zach-bowman/EDL/poster.pdf

# FORGETME NOT: Memory Aid Using RFID Object Detection and WiFi Communication

## Zach Bowman, Anne Pigula

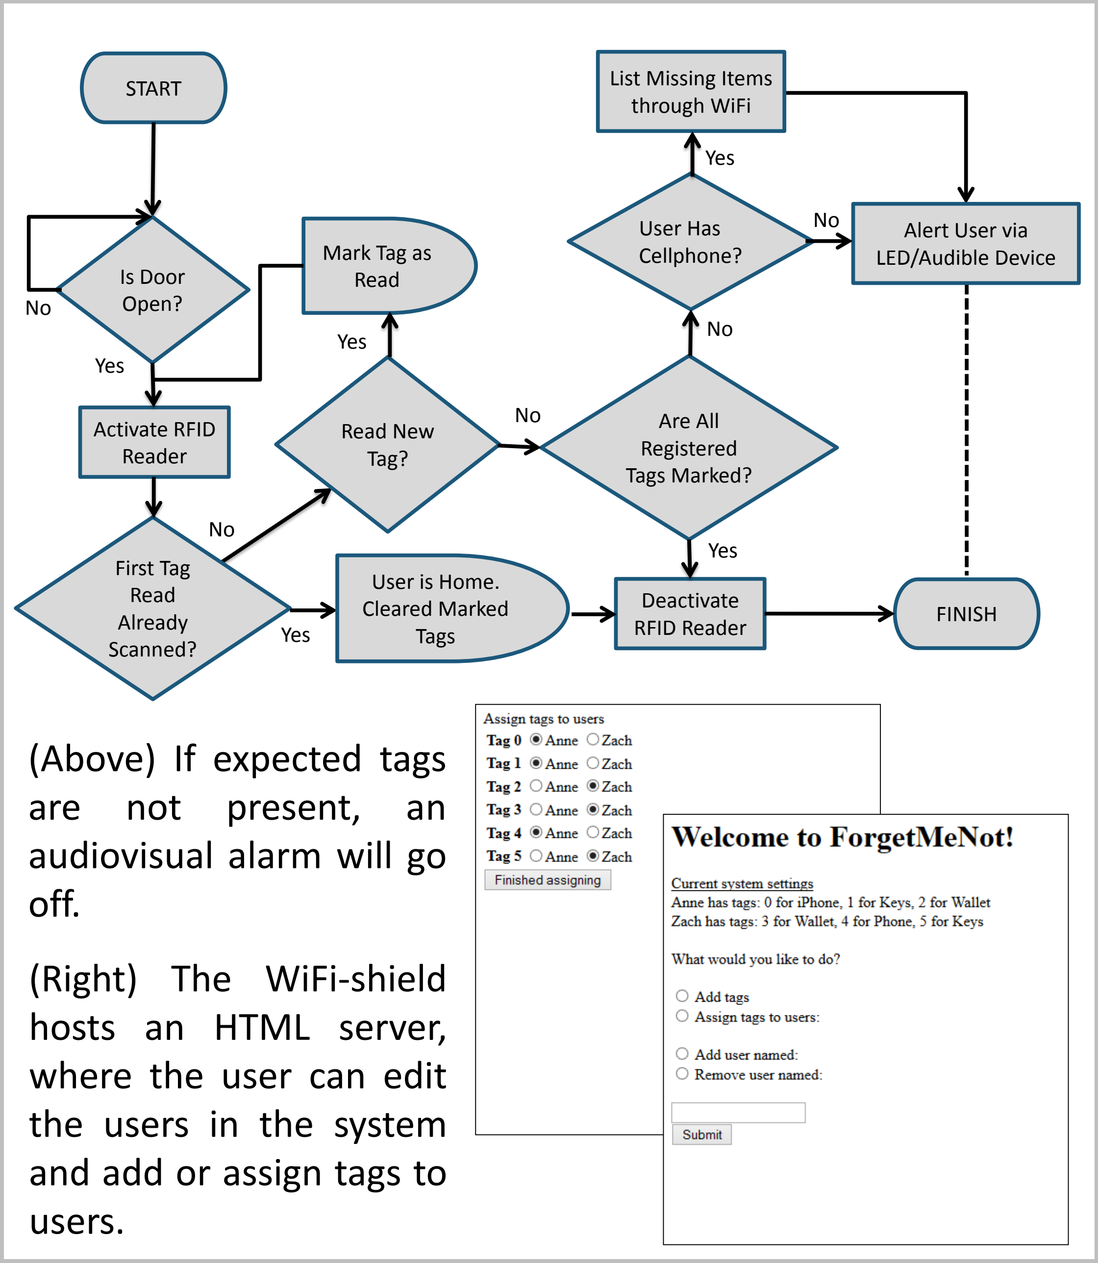
[picture p7: figure]
(Right) The WiFi-shield hosts an HTML server, where the user can edit the users in the system and add or assign tags to users.; Yes; START; Activate RFID Reader; Read New Tag?; Mark Tag as Read; Are All Registered Tags Marked?; Deactivate RFID Reader; FINISH; User Has Cellphone?; Alert User via LED/Audible Device; List Missing Items through WiFi; Is Door Open?; First Tag Read Already Scanned?; User is Home. Cleared Marked Tags; (Above) If expected tags are not present, an audiovisual alarm will go off.

Conclusions and Future Work

Device Overview

## Department of Electrical and Computer Engineering

Acknowledgements and Reference

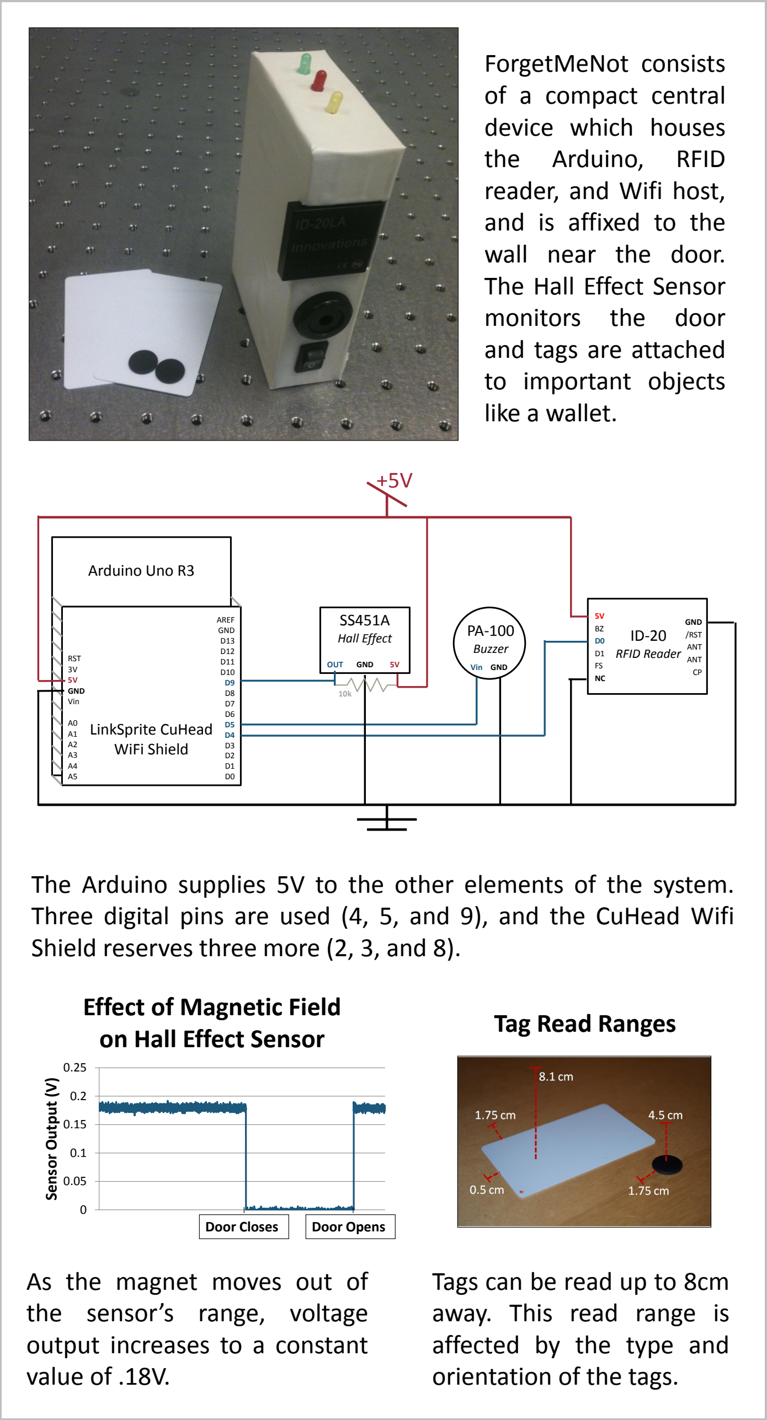
[picture p8: figure]
Tags can be read up to 8cm away. This read range is affected by the type and orientation of the tags.; As the magnet moves out of the sensor’s range, voltage output increases to a constant value of .18V.; Sensor Output (V); Effect of Magnetic Field on Hall Effect Sensor; Door Closes; Door Opens; Arduino Uno R3; LinkSprite CuHead WiFi Shield; RST 3V 5V GND Vin; AREF GND D13; ID-20 RFID Reader; GND /RST ANT ANT CP; PA-100 Buzzer; Vin GND; SS451A Hall Effect; OUT; GND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

EN.520.448 Electronics Design Lab | Spring 2013

User Feedback

ForgetMeNot is an effective model for an RFID-based memory aid system.
An ideal system would include the following upgrades:
- High-frequency RFID (~900MHz) to allow simultaneous tracking of multiple tags at a range of 1-2m
- A more powerful processor with additional memory
- A smartphone app with PUSH notifications

Introduction

Technology / Components

ID-20 RFID reader and tags: A low-frequency system with an advertised range of 20cm. Although a high-frequency system would have better range and minimal interference, the ID-20 meets our budgetary restrictions and is sufficient for a proof-of-technology model.

Arduino | Uno | R3: | A | single-board
microcontroller to manage the sensors and instruments, with 32kb of memory, as well as open-source software.

CuHead Wifi Shield for Arduino: Provides wireless connectivity to the Arduino, allowing the system to host a server on the local internet.

SS451A Hall Effect sensor and magnet: A simple proximity sensor which indicates when the door is opened

A PA-100 piezoelectric buzzer and LEDs: Provide audiovisual feedback when an object is forgotten.

RFID

Radio | Frequency | Identification
(RFID) | uses | radio | frequency
electromagnetic | fields | to
communicate over distances of up to 30m. System specifications depend on the type of tag used (active or passive) and the read frequency (100 kHz – 5.8 GHz).

The Arduino supplies 5V to the other elements of the system. Three digital pins are used (4, 5, and 9), and the CuHead Wifi Shield reserves three more (2, 3, and 8).

Special thanks to Dr. Ralph Etienne-Cummings, Jamal Molin, Xiaoyu Guo, and the Johns Hopkins Department of Electrical and Computer Engineering

[1] London Fire Brigade. “Firefighters Attending One ‘Locksmith Job’ Per Hour Title." [London]. 29 May 2012: http://www.london-fire.gov.uk.

In London alone, almost 22,000 people in the last three years required the assistance of the fire department because they had been locked in or out of their homes.

[1] These incidents
could have been avoided if the victims had remembered their keys. By utilizing RFID technology, we’ve created a user-friendly, home-integrated reminder system that ensures the user has everything they need each time they leave the house.
